igpollitzer/ahadi/informe_TL4.pdf

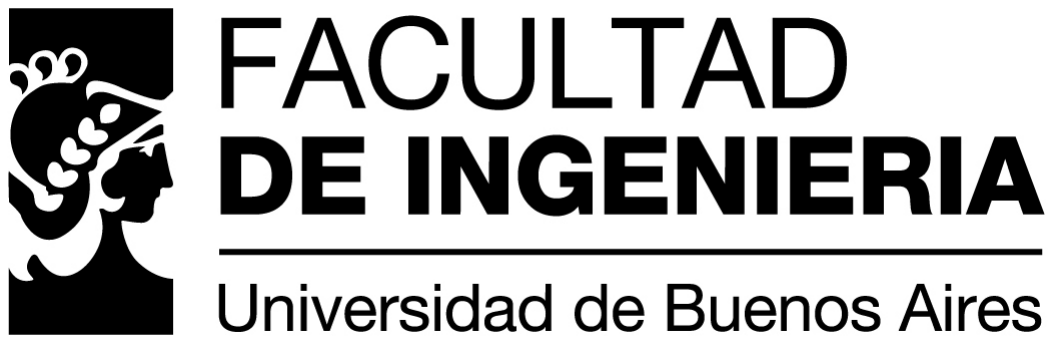
[picture p5: figure]

# Circuitos Electrónicos I [66.08]

## Julio G. Zola

## Informe: Trabajo de Laboratorio IV

Diseño Analógico: Robot seguidor de líneas.

Primer Cuatrimestre 2014

Nombre | Apellido | Padrón | Mail
Iván Gustavo | Pollitzer | 82957 | igpollitzer@gmail.com
Ignacio L. J. | Carballeda | 91646 | carballeda.ignacio@gmail.com

## Índice

1. Introducción | 3
2. Sensores | 5
3. Circuito utilizado | 6
4. Mediciones | 9

2

## 1. Introducción

El objetivo de este trabajo es realizar un robot seguidor de líneas utilizando componentes analógicos. Un seguidor de líneas es un simple robot móvil, ideal para los que se inician en la robótica. Tal es así que es considerado el ”hola mundo” del mundo robotico.

Básicamente el objetivo del robot es seguir una línea que describe un circuito cerrado. Para la implementación de este tipo de robot generalmente se utilizan microcontroladores ya que permiten tomar decisiones mas ”inteligentes” para recorrer la pista en el menor tiempo posible.


Figura 1: Robot seguidor de lineas.

3

### 1.1. Idea de funcionamiento

El circuito sobre el cual se tiene que desplazar el robot consta de una linea blanca (brillante) con fondo negro (opaco).

El robot es dotado de dos sensores ubicados de manera tal que puedan medir el suelo y dos motores que funcionan de manera independiente. La idea es que cuando ambos sensores estén sobre la línea, el robot avance de manera recta. Cuando, por ejemplo, el sensor del lado derecho salga de la línea, el motor izquierdo detiene su marcha, haciendo de esta manera que el vehículo gire hacia la izquierda para volver sobre la línea blanca.


Figura 2: idea

4

## 2. Sensores

Para permitir que el robot pueda distinguir la línea blanca del fondo negro utilizamos dos sensores CNY70.
El CNY70 es un sensor de corto alcance, compuesto por un emisor de luz (diodo infrarrojo) y un receptor (foto-transistor), ambos apuntando en la misma dirección. Su funcionamiento se basa en la capacidad de reflexión del objeto, y la detección del rayo reflectado por el receptor.

El mismo tiene cuatro pines de conexión. Dos de ellos se corresponden con el ánado y cátodo del emisor, y las otras dos se corresponde con el colector y el emisor del receptor.


Figura 3: CNY70

5

## 3. Circuito utilizado

### 3.1. Requerimientos

Los motores sometidos a una diferencia de potencial de 4 V consumen 40 mA, cuando están funcionando libremente. En cambio, cuando están siendo bloqueados físicamente, consumen 250 mA.
Necesitamos un circuito que entregue una corriente de 250 mA (peor caso) cuando el sensor detecte la línea blanca.

### 3.2. Explicación de la elección del circuito

Cuando la luz infrarroja emitida por el foto-diodo es reflejada por la superficie blanca de la línea, la base del foto-transistor (TBJ NPN) es excitada. Cuando esto sucede, la corriente por el mismo se eleva y produce un incremento de tensión en el emisor, ya que el mismo esta conectado a un resistor de 10 Kω que va a tierra.

La idea es medir la tensión en el emisor del foto-diodo y transformarla, de alguna manera, en corriente circulando por el motor correspondiente.

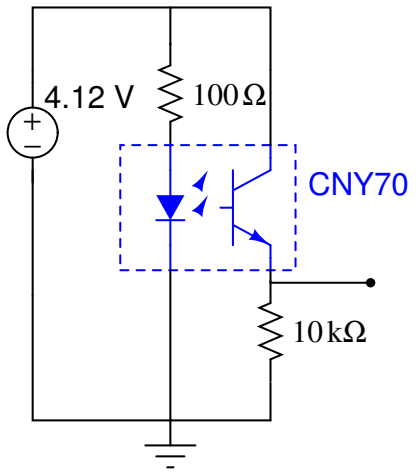
[picture p6: figure]
CNY70

Figura 4: circuito

6

Como no queremos tomar corriente del foto-diodo ya que esto provocaria su ruptura (corriente máxima Icsensor = 50 mA). Lo primero que se nos ocurrió fue conectar la base de un transistor TBJ al nodo emisor del sensor como se muestra en la siguiente figura.

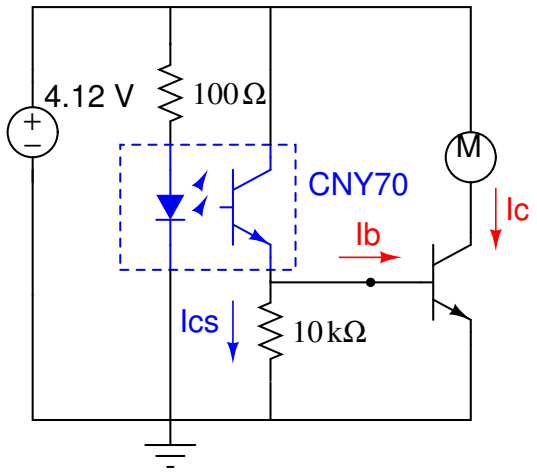
[picture p7: figure]
CNY70; Ics

Figura 5: circuito propuesto

Cuando el sensor detecta la línea blanca Icsensor =

4V
10KΩ = 0,4 mA .
Cuando el motor esta bloqueado Ic = 250 mA, por lo tanto con un βmin = 85 , Ib =

250mA
85 ' 3mA.
Como vemos el problema esta en que no podemos sacar esos 3 mA directamente del sensor. Si comparamos esta corriente con la que esta circulando por el foto-transistor veremos que no es despreciable y esto afectaría nuestra medición.

Para solucionar este problema decidimos conectar el gate de un transistor N-MOSFET con una tensión de umbral lo suficientemente baja (vth = 1 V ) al emisor del foto-transistor.
Esta decisión en principio solucionaría el problema de sacar corriente del foto-transistor. Esto es porque la corriente por gate en un MOS es casi nula.

Sin embargo ahora nos enfrentamos con otro problema. La corriente necesaria para hacer funcionar un motor excede los valores típicos de ID de los mosfet. Por esta razón se conecto el drain del NMOS a la base de un TBJ de tipo PNP.

7

De esta forma podríamos utilizar corrientes bajas, para controlar corrientes mas altas por TBJ.
El circuito quedo de la siguiente manera:

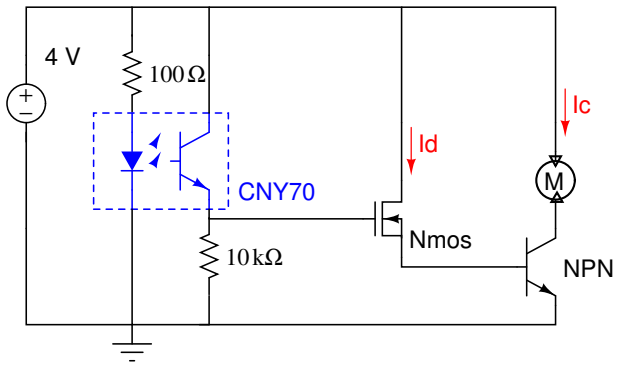
[picture p8: figure]
CNY70; Nmos; NPN

Figura 6: circuito propuesto

Cuando realizamos las mediciones nos dimos cuenta que la corriente ID del MOS era mucho mas alta de la que esperábamos ID ≈ 200 mA. Observamos que el motor funcionaba correctamente pero que el MOS se calentaba demasiado.

El circuito estaba funcionando ya que el TBJ estaba saturado y permitía la corriente necesaria por el motor. Pero era innecesariamente excesiva, la corriente que estaba circulando por el Drain del MOS.

Con una corriente por Drain de 3 mA ya es suficiente dado que
IC = βmin ∗ ID = 85 ∗ 3 mA = 255 mA.
La resistencia que impone el canal formado a la corriente continua es de aproximadamente 100 Ω. Despejando:

ID =

4 − 0,7
100Ω + RD

= 3mA =⇒ RD = 1KΩ

Por lo tanto agregamos un resistor RD = 1 KΩ entre el Drain del MOS y VCC.

Los transistores que elegimos fueron sobredimensionados para cubrirnos ante posibles fallas.

8

TBJ = NPN BD329 (Corriente máx = 3 A, disipación máx = 15 W , 85 5 hf e 5 375 )

MOS = NMOS BSS88 (IDmax = 250 mA , disipación = 1 W, 0,6V 5 vth 5 1,6V ,10nA 5 IGSS 5 100nA )

Quedando finalmente el circuito configurado de la siguiente manera:

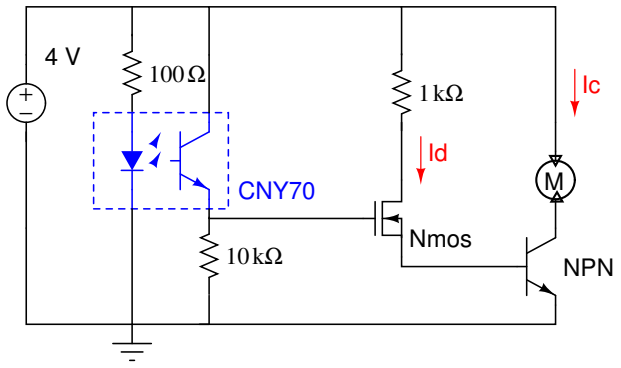
[picture p9: figure]
CNY70; Nmos; NPN

Figura 7: circuito final

## 4. Mediciones

### 4.1. Mediciones sobre TBJ

Color | Motor | VCE | IC
Blanco | libre | 18 mV | 41 mA
Blanco | bloqueado | 81 mV | 195 mA
Negro | libre | 4.13 V | 0 A

### 4.2. Mediciones sobre MOSFET

Color | Motor | VDS | ID | VG
Blanco | libre | 13 mV | 3.4 mA | 3.92 V
Blanco | bloqueado | 12.8 mV | 3.3 mA | 3.92 V
Negro | libre | 3.64 V | 0 A | 34 mV

9
