igpollitzer/ahadi/imagenes/ahadi.png

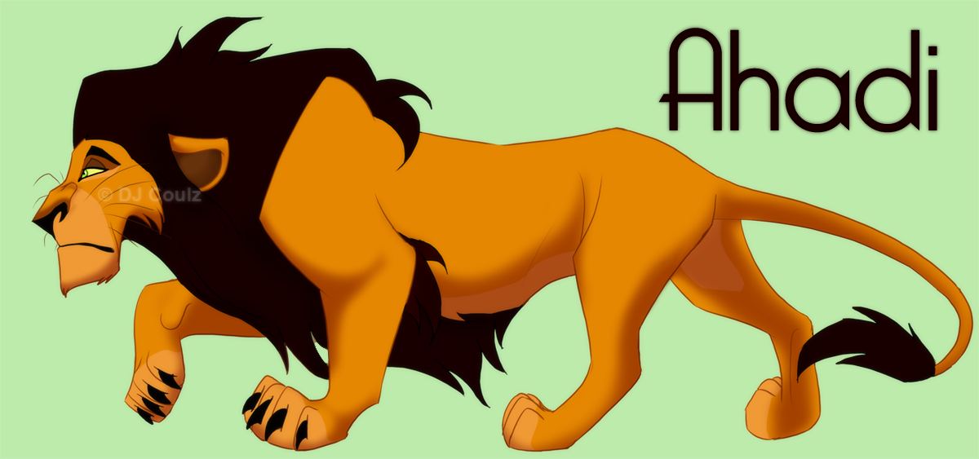
imagenes/ahadi.png
