igpollitzer/ahadi/imagenes/circuito.png

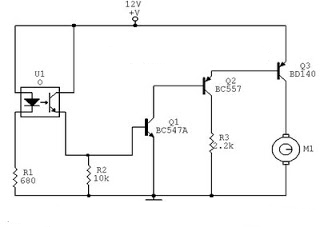
imagenes/circuito.png
