igpollitzer/ahadi/imagenes/diagrama.jpg

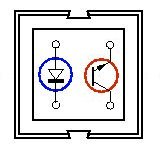
imagenes/diagrama.jpg
