igpollitzer/ahadi/imagenes/sensores.jpg

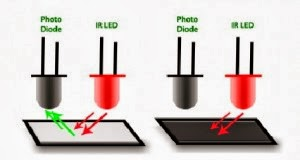
imagenes/sensores.jpg
