igpollitzer/ahadi/simulaciones/TL4.asc

M1: nmos; transNMOS
Q1: npn; transNPN
R1: res; 10k
R2: res; 15
V1: voltage; PULSE(0.100 3.7 0.5 0.01 0.01 0.5 3 5)
V2: voltage; 3.7
Named nets: 0
.tran 2
.model transNMOS nmos( VTO=1 KP=2m)
motor consume 250mA a 3.7v
.model transNPN  NPN( BF=300 )
