igpollitzer/ahadi/ahadi PCB/ahadi.kicad_pcb

## KiCad design ahadi PCB/ahadi.kicad_pcb (2016-11-23)

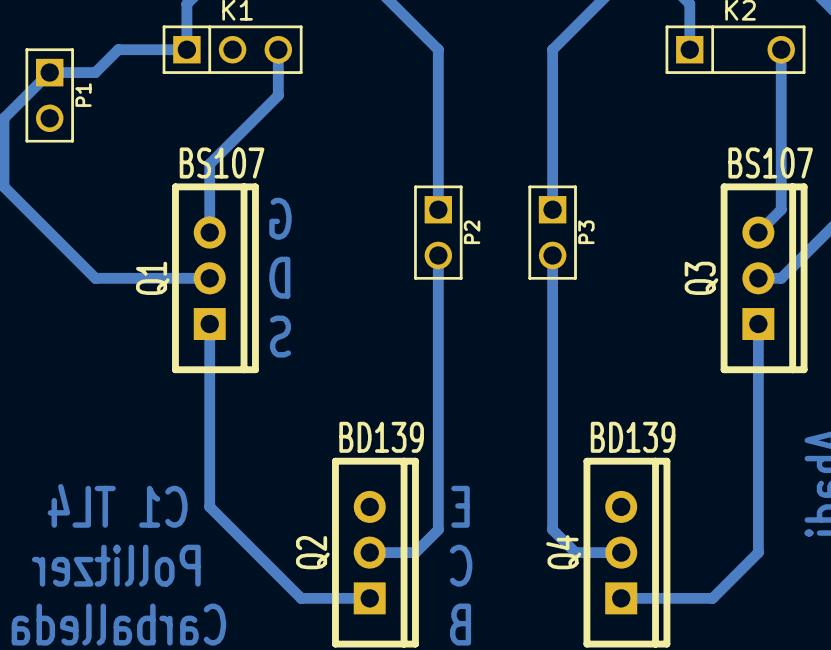
[picture p14: board ahadi.kicad_pcb from above]

Board: 2 copper layers, 9 parts (0 on the bottom side), 9 nets.

Parts:
K1, K2: CONN_3; PIN_ARRAY_3X1
P1, P2, P3: CONN_2; PIN_ARRAY_2X1
Q1, Q3: BS107; TO220_VERT
Q2, Q4: BD139; TO220_VERT

Connections:
unnamed: P3.2, Q4.2
unnamed: K2.3, Q3.2
unnamed: K2.2, Q4.1
unnamed: Q3.3, Q4.3
unnamed: K1.1, K2.1, P1.1, P2.1, P3.1, Q1.1, Q3.1
unnamed: K1.2, P1.2, Q2.1
unnamed: P2.2, Q2.2
unnamed: K1.3, Q1.2
unnamed: Q1.3, Q2.3
